nika-cell/moon-aeroponics/Расчеты/Расчет гидравлической нагрузки.docx

Расчёт гидравлической нагрузки

Методика расчёта на Земле:

*Основной закон: P=ρgh

(м.вд.ст.) – не табличная единица измерения, обозначающая давление одного метра столба воды.

1) Первостепенно определимся с давлением насоса.

Используя закон гидростатики* определим давление столба жидкости в граничном случае, когда при вертикальном положении трубки вода ещё не выходит за её границы. Таким образом предельная высота столба жидкости составила 2.9 метра, следовательно, P = 2.9 м.вд.ст.

2) Рассчитаем давление столба жидкости* в условиях строения лунной базы. Предполагаем высоту установки 1.5 метра. Тогда Pст = 1.5 м.вд.ст.

3) Оценим давление на одной форсунке. Для этого установим одну форсунку на конце трубки и замерим предельную высоту, при которой на форсунку всё ещё подаётся вода. Таким образом высота столба жидкости составила 2.7 метра, следовательно, одна форсунка принимает на себя Pфорс = 0.2 м.вд.ст.

4) Из аддитивности давления составим равенство: P_(нас) =P_(ст) +n×P_(форс) , из которого рассчитаем количество форсунок, где Pнас – давление насоса; Pст – давление нового столба жидкости; Pфорс – давление на одной форсунке; n – число форсунок.

2.9 = 1.5 + n*0.2 n = 7

Расчёт угла раствора форсунки:

Методика расчёта: эксперимент.

1) Расположим включённую форсунку на расстоянии 10 см от листа бумаги А4 и замерим диаметр получившегося пятна. Диаметр равен также 10 см.

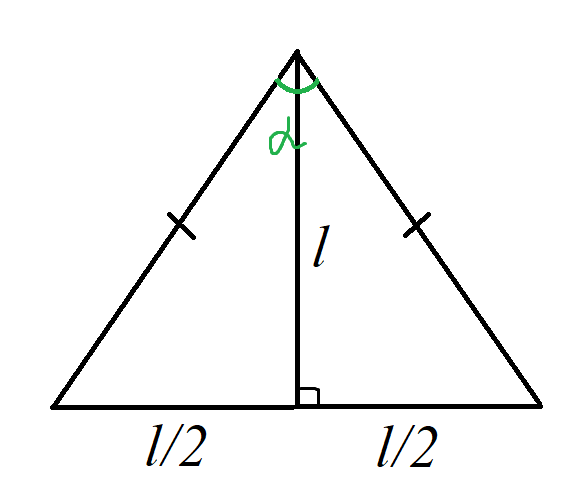
[picture p1: figure]

2) Проиллюстрируем геометрическую интерпретацию результатов эксперимента:

Здесь основание треугольника – лист бумаги. Из геометрических соображений находим, что α≈53.14
