nika-cell/moon-aeroponics/Расчеты/Расчет положения отражателей.docx

Расчёт расстояния от стенок установки до отражателей

Определим расстояние l от стенки до отражателя.

Учитывая, что α = 67.5°, R = 7.75. Из геометрических соображений находим, что l = 10.36

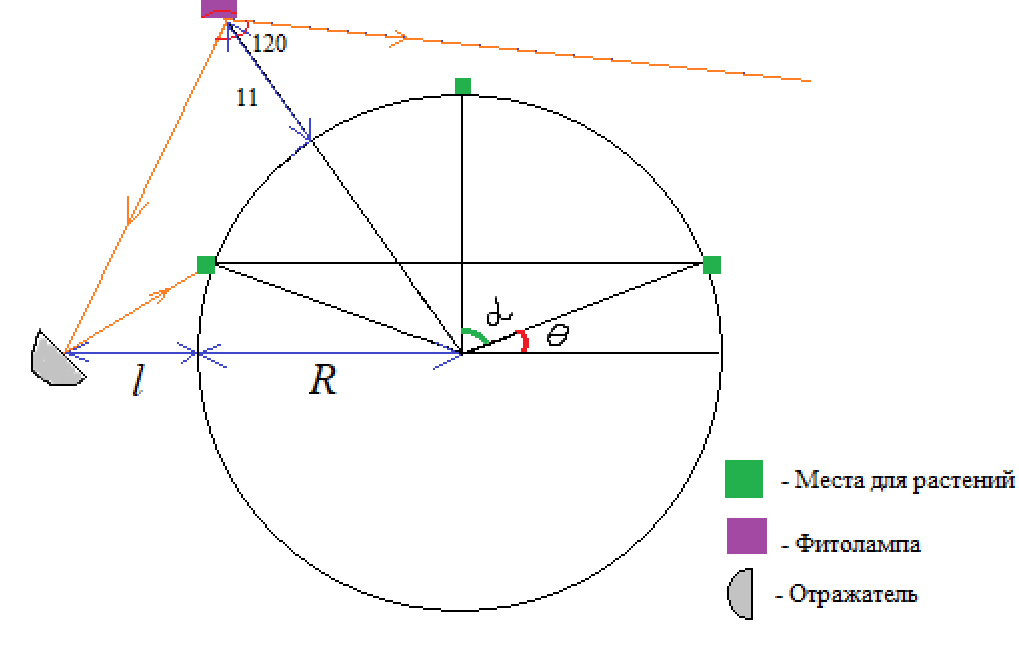
[picture p2: figure]
