nika-cell/moon-aeroponics/Расчеты/Тесты для установки.docx

Программа и методика предварительных испытаний.

Объект испытаний
Объектом испытаний является экспериментальный образец аэропонной установки в полной комплектации, включающий в себя:

- герметичный цилиндрический корпус высотой 1,5 м с ячейками, расположенными в секторе 135 градусов (10 рядов по 3 решётчатые колбы, ориентированные под углом 45 градусов внутрь объёма);
- систему орошения низкого давления на основе форсунок (расход 0,285 мл/с) и насоса;
- систему принудительной сепарации аэрозоля на основе верхнего вентилятора с выходным отверстием площадью 0,006 м²;
- приёмное ведро для сбора воды, герметично закреплённое в нижней части корпуса;
- систему освещения в составе шести фитоламп (фотопериод 16 часов) и УФ-лампы (непрерывный режим);
- систему управления на базе микроконтроллера Raspberry Pi Pico с периферийными модулями: датчик температуры и влажности DHT11, фоторезисторный модуль LM393, датчик погружения Funduino, дисплей LCD 2004 с интерфейсом I2C, энкодер KY-040, четырехканальный релейный модуль.

Цель испытаний.
Целью проведения предварительных испытаний является подтверждение работоспособности и функциональной пригодности установки к эксплуатации, а именно:

- проверка корректности и помехоустойчивости работы электронных компонентов системы управления;
- верификация заданных временных циклов орошения, вентиляции и освещения;
- подтверждение эффективности гидродинамической схемы: доставка аэрозоля в корневую зону, удержание влаги на корнях, отсутствие нештатных утечек влаги через вентиляционное отверстие;
- выявление конструктивных и программных дефектов, препятствующих стабильной работе установки в непрерывном режиме.

1. Электроника.

1.1 Проверка релейного модуля управления нагрузкой

Применяемое оборудование: стендовый источник питания, фитолампы и насос в сборе, модуль реле Songle SRD-05VDC-SL-C, Raspberry Pi Pico с тестовой прошивкой.

Методика проведения: Релейный модуль подключается к нагрузке согласно электрической схеме. На микроконтроллер загружается скетч, выполняющий следующий цикл: реле №1 замкнуто 3 секунды, пауза 2 секунды, реле №2 замкнуто 3 секунды, пауза 2 секунды. Цикл повторяется 10 раз. В ходе выполнения цикла производится визуальный контроль включения фитоламп и насоса, а также аудиальный контроль щелчков реле.

Критерии положительного результата:

- Каждое реле издаёт однократный чёткий щелчок при замыкании и размыкании. Дребезг или многократное срабатывание не допускаются.
- Микроконтроллер не уходит в перезагрузку при коммутации насосной нагрузки.
- Лампы и насос включаются и выключаются синхронно с управляющим сигналом.

1.2 Проверка датчика температуры и влажности DHT11.

Применяемое оборудование: датчик DHT11, микроконтроллер Raspberry Pi Pico, дисплей LCD 2004 или монитор последовательного порта, гидрофобный защитный колпачок из мелкопористого поролона (опционально).

Методика проведения: Датчик подключается к микроконтроллеру. Загружается скетч циклического опроса датчика с периодом 2 с и выводом измеренных значений температуры и влажности на дисплей или в монитор порта. На первом этапе датчик работает в сухом состоянии при нормальных комнатных условиях в течение 5 мин; показания должны оставаться стабильными, без скачков. На втором этапе датчик помещается в корпус установки на штатное место и запускается рабочий цикл орошения. Наблюдение за показаниями ведётся непрерывно в течение не менее 30 мин. Особое внимание уделяется моментам возрастания влажности выше 90% и последующему поведению датчика после рассеивания тумана.

Критерии положительного результата:

- В сухом состоянии показания температуры и влажности соответствуют комнатным, разовые отклонения не превышают 5% относительной влажности и 2 °C.
- При работе в аэрозольной среде показания изменяются монотонно, без мгновенных провалов до 0% и без неограниченно долгого удержания максимального значения 99% после прекращения подачи тумана.
- При обнаружении склонности датчика к конденсационному запиранию на плате должно быть предусмотрено размещение датчика в зоне вне прямого потока капель и установка защитного гидрофобного колпачка.

1.3 Калибровка и проверка датчика освещённости на модуле LM393

Применяемое оборудование: модуль датчика освещённости на LM393, микроконтроллер Raspberry Pi Pico, фитолампы и УФ-лампа в сборе, отвёртка для регулировки резистора.

Методика проведения: датчик освещённости устанавливается в корпус установки в зоне действия фитоламп и УФ-лампы. Микроконтроллер программируется на непрерывное считывание цифрового выхода компаратора. Дожидаются момента выключения фитоламп по программе при продолжающейся работе УФ-лампы. Медленно вращая резистор, добиваются переключения выходного сигнала компаратора из состояния логической единицы в состояние логического нуля. Затем принудительно включают фитолампы и убеждаются, что сигнал возвращается в состояние логической единицы. Для обеспечения запаса помехоустойчивости резистор доворачивают немного дальше найденной границы в сторону тёмного порога.

Критерии положительного результата:

- При выключенных фитолампах и включённой УФ-лампе выход компаратора стабильно удерживает логический ноль.
- При включении фитоламп выход компаратора без задержек переключается в логическую единицу.
- Ложные срабатывания, вызванные отражённым светом или флуктуациями яркости УФ-лампы, не регистрируются.

1.4 Проверка датчика погружения Funduino

Применяемое оборудование: датчик погружения Funduino, микроконтроллер Raspberry Pi Pico, шприц или пипетка с водой.

Методика проведения: датчик закрепляется вертикально в положении, соответствующем его будущей установке в корпусе. Выходной сигнал датчика выводится на монитор порта или дисплей. С помощью шприца вода медленно подаётся на верхнюю часть чувствительного элемента, имитируя стекание плёнки по стенке. Контролируется момент изменения выходного сигнала. Тест повторяется несколько раз для оценки воспроизводимости порога срабатывания.

Критерии положительного результата:

- Датчик фиксирует наличие влаги при появлении тонкой водяной плёнки на поверхности чувствительного элемента, до момента формирования сплошного потока или полного погружения.
- После прекращения подачи воды и высыхания контактов выходной сигнал возвращается в исходное состояние.

1.5 Энкодер KY-040 и дисплей LCD 2004.

Применяемое оборудование: энкодер KY-040, дисплей LCD 2004 с модулем I2C, микроконтроллер Raspberry Pi Pico, полностью собранная установка с релейным модулем, насосом и лампами.

Методика проведения: на дисплей выводится интерфейс с изменяемой переменной (значение от 0 до 100). Энкодер программируется на изменение этой переменной с шагом 1 на один щелчок. В фоновом режиме запускается полный рабочий цикл орошения и вентиляции, чтобы реле периодически коммутировали нагрузку насоса и фитоламп. В течение 5 мин оператор активно вращает энкодер, изменяя значение переменной, и одновременно наблюдает за дисплеем.

Критерии положительного результата:

- Значение переменной изменяется строго на 1 единицу за один механический щелчок энкодера. Пропуски шагов или скачки на 2 и более единиц не допускаются.
- В моменты коммутации реле дисплей не моргает, не гаснет и не отображает нечитаемые символы.
- При обнаружении сбоев, вызванных просадками напряжения, в схему должны быть добавлены сглаживающие конденсаторы по питанию микроконтроллера и дисплея, а также проверена целостность цепей заземления.

1.6 Общий шестичасовой тест электроники в полном рабочем цикле

Применяемое оборудование: установка в полной комплектации, микроконтроллер Raspberry Pi Pico с итоговой рабочей прошивкой.

Методика проведения: на микроконтроллер загружается скрипт, реализующий непрерывный рабочий цикл: форсунки включены 10 с, пауза, вентилятор включён 15 с, пауза до истечения трёхминутного интервала. Параллельно ведётся отсчёт времени для 16-часового фотопериода фитоламп. УФ-лампа и электроника запитаны непрерывно. Раз в минуту в монитор порта или в лог-файл выводятся значения всех датчиков и текущие состояния реле. Установка функционирует без вмешательства оператора в течение 6 ч.

Критерии положительного результата:

- За весь период испытаний не зафиксировано ни одной перезагрузки или зависания микроконтроллера.
- Таймер фотопериода не сбивается, фактическое время включения и выключения фитоламп соответствует заданному.
- Связь со всеми датчиками сохраняется, в логах отсутствуют периоды с нулевыми или заведомо некорректными показаниями.

2. Гидродинамика.

2.1. Проверка отсутствия выноса влаги через вентилятор на пустой камере

Применяемое оборудование: установка без растений, плёнка для герметизации посадочных отверстий, вода, салфетка из гигроскопичного материала, мерная ёмкость.

Методика проведения: все отверстия для колб герметично заклеиваются плёнкой, формируя замкнутый внутренний объём. В резервуар форсунок заливается отмеренное количество воды. Запускается рабочий цикл: раз в 3 мин форсунки распыляют туман (10 с), затем включается вентилятор (15 с). Установка выдерживается в таком режиме 1 ч. В течение этого часа к выходному отверстию вентилятора периодически прикладывается сухая салфетка на время одного полного цикла вентиляции. По истечении часа из приёмного ведра извлекается и измеряется объём собранной воды.

Критерии положительного результата:

- Салфетка за 15 с работы вентилятора не становится заметно влажной; допустимо ощущение лёгкого холодка без видимого увлажнения.
- В приёмном ведре регистрируется наличие воды, что подтверждает работоспособность системы сбора жидкости.
- Зафиксированный объём воды документируется в качестве базового значения для последующего сравнения.

2.2. Проверка удержания аэрозоля корневой системой на камере с растениями

Применяемое оборудование: установка с растениями, высаженными в колбы согласно штатной схеме, вода, мерная ёмкость.

Методика проведения: в резервуар заливается такое же количество воды, что и в тесте по п. 2.2.1. Запускается идентичный рабочий цикл орошения и вентиляции, продолжительность теста также составляет 1 ч. По окончании измеряется объём воды в приёмном ведре. Полученное значение сравнивается с базовым объёмом, зафиксированным при испытании пустой камеры.

Критерии положительного результата:

- Объём воды, собранной при работающей установке с растениями, существенно (не менее чем на 30 %) меньше базового объёма, полученного на пустой камере. Это свидетельствует об эффективном осаждении и удержании тумана корневой системой.
- Если разница объёмов составляет менее 30 %, требуются дополнительные работы по регулировке направления форсунок или изменению длительности и мощности вентилятора.

2.3. Осмотр камеры на предмет застоя воды и корректности воды

Применяемое оборудование: установка после проведения тестов по пп. 2.1. и 2.2., шприц с водой.

Методика проведения: камера вскрывается, производится визуальный осмотр внутренних стенок, дна и посадочных колб. Проверяется отсутствие луж вне приёмного ведра и скоплений воды в локальных углублениях. В каждую колбу шприцем подаётся небольшое количество воды, отслеживается направление стекания: жидкость должна возвращаться внутрь камеры, а не вытекать наружу к листьям.

Критерии положительного результата:

- Лужи и застой воды на горизонтальных поверхностях и в углублениях дна отсутствуют.
- Угол наклона колб (45°) обеспечивает стекание конденсата внутрь камеры; вытекание воды наружу к листовой части растений не зафиксировано.

2.4. Проверка влияния вентилятора на температурный режим корневой зоны

Применяемое оборудование: датчик DHT11 (или автономный датчик температуры), размещённый непосредственно в корневой зоне одного из средних ярусов.

Методика проведения: в процессе общего длительного теста или отдельного часового прогона непрерывно регистрируется температура в корневой зоне. Сравниваются показания в моменты работы вентилятора и в паузах. Важно убедиться, что вентилятор, сдувая капли, не перегревает и не переохлаждает корневую зону за счёт интенсивного движения воздуха.

Критерии положительного результата:

- Колебания температуры в корневой зоне в течение полного цикла (3 минуты) не превышают 3 °C.
- Температура не выходит за пределы оптимального для тестовой культуры диапазона (обычно 18-26 °C).
- Если перепады значительны, рассматривается снижение оборотов вентилятора или увеличение паузы между орошением и вентиляцией.
