nika-cell/moon-aeroponics/Расчеты/Отчёт влияния установки (тепловыделение и влаговыделение) на лунную базу.docx

Отчет влияния аэропонной установки (тепловыделение и влаговыделение) на лунную базу.

Интеграция аэропонной установки в замкнутый контур лунной базы требует точной оценки её влияния на общую экосистему модуля. Имея энергопотребление в 238,18 Вт, комплекс выступает не только потребителем ресурсов, но и активным источником тепла и влаги за счет работы оборудования и испарения воды растениями. Этот отсчёт анализирует эти факторы для бортовых систем терморегулирования и кондиционирования. Главной целью отсчёта является обосновать соразмерность нагрузок и доказать, что выделения установки не окажут сильного влияния на инфраструктуру базы.

1) Тепловыделение

Для оценки степени воздействия ниже приведено сопоставление параметров проектируемого оборудования с номинальными эксплуатационными лимитами как всей станции, так и отдельных лабораторных модулей (например, МЛМ-У «Наука»).

Параметр СЭС | Значение для МКС / Модулей | Параметр нашей нагрузки | Доля от лимита станции / модуля
Допустимое постоянное потребление МКС | 75 000 – 90 000 Вт (75–90 кВт) | 238,18 Вт (Общее) | ~0,29% от базового потребления станции
Пиковая мощность СЭС МКС (iROSA) | 215 000 Вт (215 кВт) | 238,18 Вт (Общее) | ~0,11% от пиковой мощности МКС
Лимит СЭС модуля «Наука» | 2 500 Вт (2,5 кВт) | 238,18 Вт (Общее) | ~9,5% от номинала одного модуля
Ограничение на полезную нагрузку РС | 1 500 Вт (1,5 кВт на модуль) | 238,18 Вт (Общее) | ~15,8% от лимита научных систем модуля

Проектируемый комплекс оборудования имеет совокупное энергопотребление 238,18 Вт, что составляет менее одной трети процента от постоянной располагаемой мощности МКС и полностью удовлетворяет ограничениям по полезной нагрузке для Российского сегмента (1,5 кВт).

Итоговый вывод: Эксплуатация данной аппаратуры абсолютно безопасна, полностью исключает риски перегрузки бортовой сети и не нанесет ущерба энергоснабжению других систем станций.

2) Влаговыделение

Проектируемая аэропонная установка представляет собой закрытый вертикальный цилиндр, который практически изолирован от внешней среды. Единственными каналами связи с атмосферой лунной базы являются листья растений, выведенные наружу, и небольшое отверстие сверху площадью 0,006 м², где установлен вентилятор. Проведенные расчеты показывают, что благодаря такой конструкции и прерывистому режиму полива установка выделяет минимальное количество влаги и оказывает минимальное влияние на станцию.

1) Форсунки работают 10с раз в 3 минуты. Это 480 циклов в сутки. Проведя расчеты, мы определили, что производительность форсунок равна 0.285 мл/с. Тогда за один впрыск длительностью 10 секунд форсунки расходуют 0.285*10 = 2.85мл. Общая масса воды, участвующей в одном цикле (за все 480 циклов) = 2.85*480 = 1368мл = 1,37л.

Вентилятор дует 15 секунд после выключения форсунок. Этот направленный поток воздуха действует в одном направлении с силой тяжести и прижимает туман к стенкам цилиндра, что также уменьшает испарение влаги наружу.

2) Около 55% всей воды, выдуваемой форсунками корни впитают в себя. Это влага испариться листьями наружу: 1.37л * 0.55 = 0.75 л/сут.

3) Также стоит учесть, что пока вентилятор отключен (165 секунд из 180 в каждом цикле), влажный воздух из бочки медленно уходит наружу через верхнее отверстие S=0,006м² за счет разности давлений и диффузии молекул пара. Возьмем усредненное значение, около 15%: 1.37л * 0.15 = 0.21 л/сут.

ИТОГО: 0.75 + 0.21 = 0.96 л/сут.

4) Чтобы оценить критичность получившихся 0.96 л/сут., сопоставим их со стандартными космическими показателями СЖО:

- Один космонавт только при дыхании и потоотделении выделяет в среднем 2 л/сут влаги. Наша установка выделяет около 0.96 л/сут.
- Бортовые системы кондиционирования воздуха (как на МКС) штатно рассчитаны на сбор до 30 литров (ИМБП РАН “СИСТЕМЫ ЖИЗНЕОБЕСПЕЧЕНИЯ ОБИТАЕМЫХ КОСМИЧЕСКИХ ОБЪЕКТОВ”) конденсата в сутки. Наша установка займет от этой мощности всего: 0.96л/30л * 100 = 3.2% - что является минимальным влиянием на общую систему СЖО.

Из всего вышесказанного следует, что нагрузка на систему осушения воздуха лунной базы составляет всего около 3%. Это уменьшает риск появления избыточной сырости, плесени или короткого замыкания приборов.
