nika-cell/moon-aeroponics/Расчеты/Расчёт ламп.docx

Расчёт расстояния h от ламп до растений.

Метод расчёта: теоретический

Основные формулы:

* PPFD=Φ/S ; где Φ – фотонный поток одной лампы = 36 мкмоль/с, S – эффективная площадь засветки.

**S = W×L; где W – ширина засветки, L – длина лампы.

*** W=2×h×tan(α/2) , где α – угол раствора одной лампы, экспериментально определённый как 120°

Кейл, мангольд и базилик – светолюбивые культуры. Для активного набора биомассы им требуется PPFD в диапазоне 200-300 мкмоль/м²*с при периоде освещения 16 часов.

Из формул, приведённых выше с учётом количества ламп, равного 6 определим расстояние от ламп до растений в разные стадии роста, объединив примерные диапазоны показаний PPFD.

Растения | Диапазон PPFD (мкмоль/м²*с)
| Проращивание семян | Нарост зелёной массы
Кейл | 200-400 | 400-700
Мангольд | 100-200 | 250-400
Базилик | 100-300 | 250-400

Итого:

PPFDпроращ = 200 мкмоль/м²*с => h1 = 0.21 м

PPFDнар = 400 мкмоль/м²*с => h2 = 0.1 м
