nika-cell/moon-aeroponics/Расчеты/Концепция лунных баз, системы жизнеобеспечения и космические оранжереи.docx

### Отчет: Концепция лунных баз, системы жизнеобеспечения и космические оранжереи

#### 1. Зачем человечеству лунные базы?

Создание постоянно действующих баз на Луне является ключевым этапом в трансформации подходов к освоению космоса, обусловленным несколькими стратегическими и практическими причинами:

- Использование местных ресурсов (ISRU): Луна рассматривается как источник важнейших ресурсов, в первую очередь — водяного льда, обнаруженного в постоянно затененных полярных кратерах. Лед можно перерабатывать в питьевую воду, кислород для дыхания экипажа и водородно-кислородное ракетное топливо. Местный грунт (реголит) планируется плавить и использовать для 3D-печати строительных конструкций. В долгосрочной перспективе Луна интересна добычей изотопа гелия-3 для чистой термоядерной энергетики и редкоземельных металлов.
- Подготовка к полетам на Марс: Луна является идеальным испытательным полигоном. В условиях вакуума, космической радиации, абразивной лунной пыли и пониженной гравитации (1/6 от земной) человечество сможет отработать замкнутые системы жизнеобеспечения, ядерные генераторы, скафандры и робототехнику перед отправкой людей на Марс.
- Наука и геополитика: Освоение Луны связано с геополитическим соперничеством космических держав за стратегически важные территории, особенно на Южном полюсе. Кроме того, база на обратной стороне Луны позволит разместить астрономические обсерватории, свободные от радиопомех Земли.

#### 2. Архитектурный облик лунной базы

Сегодня формируются две основные концепции лунных баз — американская (программа Artemis) и российско-китайская (Международная научная лунная станция, МНЛС). Обе станции планируется разместить в районе Южного полюса Луны, так как там есть пики вечного света для солнечных батарей и лед в темных кратерах.

- Облик базы Artemis (Artemis Base Camp): Центральным элементом станет Базовый обитаемый модуль (FSH). Он представляет собой трехэтажную гибридную конструкцию высотой около 7,8 метра. Нижний ярус — это жесткий металлический цилиндр (диаметром 4,4 м), где разместятся шлюз, зона очистки скафандров от пыли и мастерская. Два верхних этажа заключены в надувную оболочку (в развернутом виде диаметром 6,5 м), где будут находиться спальные каюты, медицинский отсек, биологическая лаборатория и тренажеры для поддержания мышечной массы. По поверхности космонавты будут перемещаться на открытых луноходах и внутри Герметичного ровера.
- Облик МНЛС (Россия/Китай): Эта база будет иметь высокоавтоматизированную распределенную структуру, в том числе с возможностью подземного базирования. Китайские инженеры рассматривают развертывание надувных жилых модулей внутри естественных лунных пещер — лавовых трубок, что обеспечит идеальную защиту от радиации, метеоритов и резких перепадов температур. Над входами в пещеры мобильные роботы-3D-принтеры напечатают защитные купола из реголита, а сообщение с поверхностью обеспечит лифт. Энергию базе должна давать компактная автоматическая ядерная электростанция (например, российская установка на базе реактора «Елена-АМ»).

#### 3. Экипаж: численность и сроки пребывания

Продолжительность нахождения людей на Луне ограничивается запасами ресурсов и предельными дозами радиации, поэтому длительность миссий будет увеличиваться постепенно.

- Программа Artemis: На первом этапе высадки (миссия Artemis III) на поверхность отправятся 2 астронавта на 7 суток. В дальнейшем (после 2028-2030 гг.), когда будет построен модуль FSH, экипаж расширится до 4 человек, а срок пребывания составит от 30 до 45 суток (в перспективе — до 60 дней или 2 месяцев).
- Программа МНЛС: На первых этапах база будет строиться роботами в полностью беспилотном режиме. С 2036 года начнутся высадки пилотируемых экипажей в составе 3–4 человек. Первые вахты составят около 14 суток (один лунный день), а после введения в строй надежных укрытий и оранжерей их длительность возрастет до 60–90 суток.
- В инженерных расчетах лунных теплиц (например, европейский проект GHM) урожай и системы жизнеобеспечения оптимизируются на длительное поддержание экипажа из 6 человек.

#### 4. Космические фермы и теплицы (Оранжереи)

##### Зачем они нужны?

По мере удлинения миссий доставка всех припасов с Земли становится нерентабельной, поэтому базы должны переходить на биорегенеративные системы жизнеобеспечения (BLSS).

1. Питание: Фермы должны обеспечивать от 50% до 100% суточных калорий. Более того, длительная космическая радиация разрушает витамины в консервах, поэтому для защиты здоровья космонавтам жизненно необходима свежая пища, богатая антиоксидантами и витаминами.
2. Регенерация атмосферы и воды: Растения перерабатывают выдыхаемый углекислый газ в кислород для дыхания (фотосинтез), а также работают как биофильтры, испаряя через листья влагу (транспирация), которая затем конденсируется в чистую воду.
3. Психологическая поддержка: Уход за растениями и наличие зеленого, яркого окружения серьезно снижают психологический стресс экипажа в условиях экстремальной изоляции.

##### Конструкция лунных ферм

Космические фермы проектируются с учетом лунной гравитации и дефицита ресурсов:

- Greenhouse Module (GHM, проект ESA): Это крупная гибридная теплица, состоящая из центрального жесткого ядра (с насосами и климат-контролем) и четырех гигантских надувных лепестков. Полезная площадь выращивания составит 658 м² (в 5 ярусов), что позволит произвести 4100 кг пшеницы, сои, картофеля и салатов за 655 суток.
- Mars-Lunar Greenhouse (Университет Аризоны): Надувные цилиндрические теплицы длиной 5,5 метра, где разные растения (помидоры, клубника, салат) растут вместе по технологии "кабельной культуры" с использованием светодиодов, охлаждаемых водой.
- «Витацикл-Т» (Россия): Инновационная малогабаритная оранжерея для выращивания салатов, редиса и зелени. Она представляет собой вращающийся цилиндрический барабан, где растения растут корнями наружу, а листьями внутрь, к источнику света. Для освещения применяются монохроматические и импульсные светодиоды (красный, синий, зеленый, УФ), работающие в режиме стробоскопа (например, 1 секунда света, 3 секунды темноты), что позволяет растениям усваивать кванты света при радикальном снижении затрат электроэнергии.
- В качестве субстрата обычную землю использовать нельзя из-за гниения и непредсказуемости бактерий; вместо нее используются искусственные минераловатные коврики, гидропоника, а также войлочные ткани с ионообменными смолами.

##### Упоминаются ли методы аэропоники?

Да, методы аэропоники упоминаются напрямую. В европейском проекте оранжереи Greenhouse Module (GHM) система подачи питательных веществ (NDS) спроектирована по гибридному принципу: она сочетает аэропонные форсунки-распылители (с шагом в 20 см) и метод питательного слоя (NFT). Кроме того, при исследованиях поведения жидкостей в космосе подчеркивается, что пониженная гравитация принципиально меняет динамику движения воды. Земная гравитация естественным образом направляет потоки воды и формирует зону корней, тогда как на Луне (1/6 G) эти изменения критически влияют на смачивание почвы, а также на эффективность работы аэропоники и гидропоники, что требует адаптации распылительных насосов и систем циркуляции растворов.
