nika-cell/moon-aeroponics/Электроника/Калибровка датчиков.docx

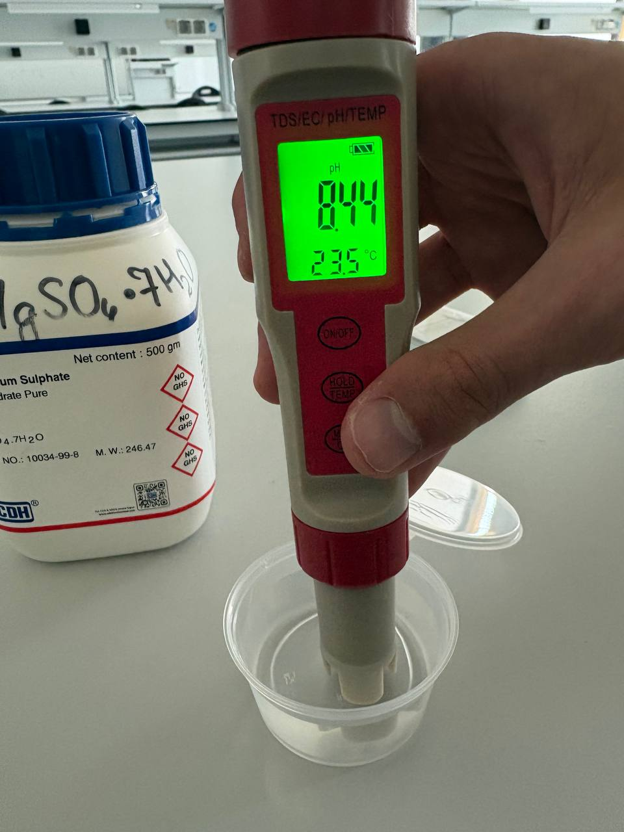
[picture p3: figure]
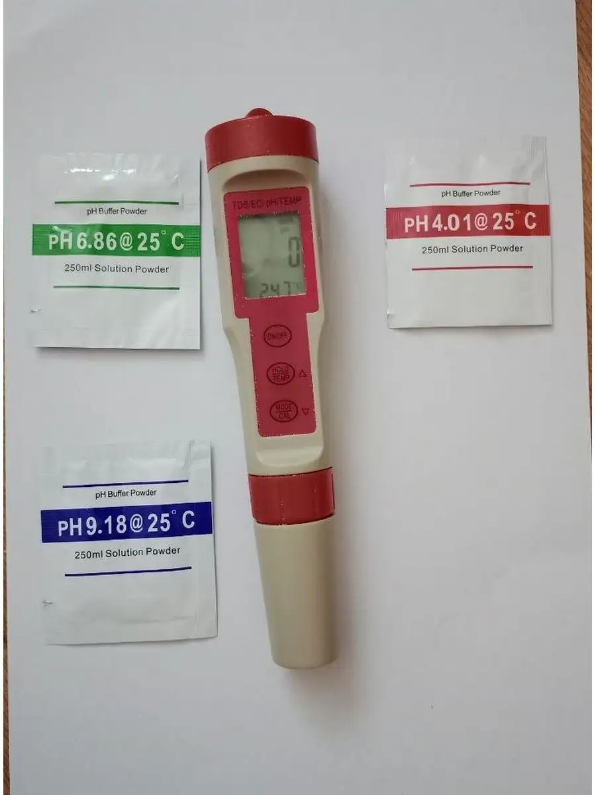
[picture p4: figure]

Калибровка датчиков

Был откалиброван датчик Water quality tester EZ-9908/686. Для этого мы использовали дистиллированную воду и набор из трёх различных pH Buffer Powder. Мы растворили каждый концентрат в отдельных емкостях с дистиллированной водой (250мл). Для начала мы измерили показатели датчика в дистиллированной воде, а затем опустили в раствор pH 9.18.

Видно, что значение неверно. Мы откалибровали датчик, опираясь на номинальные значения, указанные на упаковках. Когда значения для 3-х растворов совпали с заявленными, мы определили, что датчик откалиброван и готов к работе.

Калибровка датчика Funduino - Water Level Sensor. Для этого мы воспользовались линейной интерполяцией. Для начала мы измерили показатели датчика в полностью сухом состоянии RAW_DRY = 512. Затем датчик был полностью погружен в воду, где АЦП получил значение RAW_WET = 17100. Рабочий диапазон датчика имеет 4 см. Из разницы этих показателей был вычислен чистый рабочий диапазон устройства RANGE_VAL = 16588 единиц.

Значение в см=(Значение АЦП)/16588×4 см
