nika-cell/moon-aeroponics/Биология/Выбор культур для выращивания.docx

### Отчет о выборе культуры для выращивания

### 1. Целесообразности перехода к биорегенеративным системам жизнеобеспечения на лунной базе

Создание лунных баз требует перехода от модели снабжения с Земли к модели замкнутого цикла. При текущей стоимости лунной логистики (~$1.2 млн за 1 кг), обеспечение одного космонавта физиологической нормой свежей зелени (150 г/сутки) путем прямых поставок обойдется бюджету миссии в $16.2 млн ежемесячно. Локальное выращивание биомассы на базе аэропонной ЗСЖО полностью окупает стартовую массу оборудования всего за 4 месяца, сокращая эксплуатационные издержки почти в два раза.

Помимо математически доказанной экономической эффективности и гарантии выживания при задержках грузовых кораблей , выращивание растений в космосе решает три критические задачи:

- Регенерация среды: Растения поглощают углекислый газ и вырабатывают кислород, а также участвуют в транспирации, очищая воду внутри жилого модуля.
- Биологическая безопасность и нутритивная поддержка: Свежая продукция является источником фитонцидов и живых микроорганизмов, поддерживающих микробиом кишечника космонавтов. Кроме того, она компенсирует дефицит лабильных нутриентов, которые не могут полностью заменить синтетические добавки.
- Психологический комфорт: «Эффект оранжереи» снижает уровень стресса у экипажа, находящегося в условиях сенсорной депривации.

### 2. Ограничения сублимированных рационов и синтетических БАДов

На сегодняшний день энергетическая потребность космонавтов на МКС (2500–3000 ккал в сутки) покрывается за счет запасов сублимированных, облученных и термостабилизированных блюд. Однако для длительных лунных и марсианских миссий такая модель питания имеет два ограничения, требующих обязательной компенсации свежей фитомассой.

#### 2.1. Деградация витаминов и разрушение костной ткани

Хотя общая калорийность космических консервов сохраняется длительное время, их микронутриентный профиль стремительно разрушается. Согласно анализу Космического центра имени Линдона Джонсона (NASA), оценивающему космическую еду после 1–3 лет хранения, концентрация лабильных витаминов падает до критических значений:

- Витамин С: В фруктовых и овощных пайках деградирует на 32–83% к третьему году хранения.
- Витамин B1 и фолиевая кислота: В некоторых позициях меню (например, лепешках тортилья и овощных гарнирах) концентрация падает на 50% уже в первый год. (Источник данных: Национальная медицинская библиотека США (NCBI), "Initial assessment of the nutritional quality of the space food system over three years of ambient storage" — (https://pmc.ncbi.nlm.nih.gov/articles/PMC5466603/)https://pmc.ncbi.nlm.nih.gov/articles/PMC5466603/)

Более того, изначальная агрессивная термическая обработка (стерилизация) приводит к тому, что концентрации витамина К, калия и кальция в космических пайках стабильно оказываются на 13–20% ниже физиологической нормы космонавта.

Этот дефицит (в первую очередь витамина К и кальция) опасен для опорно-двигательного аппарата. Медицинские данные NASA подтверждают, что в условиях сниженной гравитации космонавты теряют от 1% до 1.5% минеральной плотности костной ткани ежемесячно. (Источник данных: Официальный портал NASA, "Risk of Spaceflight-Induced Bone Changes" — (https://www.nasa.gov/reference/risk-of-spaceflight-induced-bone-changes/)https://www.nasa.gov/reference/risk-of-spaceflight-induced-bone-changes/)

Синтетические витаминно-минеральные комплексы (БАДы) не могут решить эту проблему. Изолированные витамины обладают сниженной биодоступностью, так как усваиваются значительно хуже природных аналогов, работающих в растительной матрице совместно с клетчаткой и энзимами.

#### 2.2. Синдром «пищевой усталости»

Вторая фундаментальная угроза длительных миссий — нейропсихологическая. В условиях микрогравитации жидкости в теле перераспределяются, что вызывает отек слизистых и меняет чувствительность обонятельных и вкусовых рецепторов.

Длительное употребление консервированной пищи (даже при наличии 200 позиций в меню МКС) неизбежно вызывает так называемую «пищевую усталость». Сублимированные продукты теряют текстурную и вкусовую привлекательность. Как отмечают ученые Advanced Food Technology project NASA, потеря пищевого интереса приводит к тому, что экипаж систематически недополучает калории, что провоцирует опасную потерю массы тела, истощение и падение иммунитета. (Источники данных: Отчет NASA "How Does Spaceflight Change Food Appeal?" — (https://www.nasa.gov/humans-in-space/how-does-spaceflight-change-food-appeal/)https://www.nasa.gov/humans-in-space/how-does-spaceflight-change-food-appeal/ ; Исследование Мельбурнского университета — (https://pursuit.unimelb.edu.au/articles/why-do-food-and-drink-taste-different-in-space)https://pursuit.unimelb.edu.au/articles/why-do-food-and-drink-taste-different-in-space)

#### Вывод: Клиническая необходимость аэропонной биомассы

Включение в рацион свежевыращенной аэропонной фитомассы — это не просто гастрономическое удовольствие, а безальтернативный клинический инструмент жизнеобеспечения. Свежие, хрустящие листья кейла и мангольда, а также высокая концентрация эфирных масел в базилике обеспечивают мощную ольфакторную (обонятельную) и текстурную стимуляцию. Это физиологически «перезагружает» рецепторы космонавтов, преодолевает вкусовую апатию и стимулирует активную выработку пищеварительных ферментов. Одновременно с этим локальное выращивание гарантирует экипажу поставку 100% биодоступных, не деградировавших от времени витаминов C и K, останавливая разрушение костной ткани и поддерживая метаболический гомеостаз.

### 3. Сравнительный анализ сельскохозяйственных культур

Для определения оптимального состава фитомассы был проведен многофакторный анализ 15 видов листовых культур. Оценка проводилась по целевым показателям электропроводности (EC), потреблению NPK, требованиям к освещенности (PPFD) и концентрации критических микронутриентов.

Таблица 1. Матрица нутриентного и инженерного профиля культур

Культура | Целевой EC (мСм/см) | NPK профиль | PPFD (μмоль) | Вит. С (мг) | Вит. А (мкг RAE) | Вит. K (мкг) | Железо (мг) | Кальций (мг) | Магний (мг)
Кейл | 1.7 | 15-10-20 | 350 | 120 | 500 | 817 | 1.5 | 150 | 33
Базилик | 1.8 | 16-10-20 | 400 | 18 | 264 | 415 | 3.2 | 177 | 64
Мангольд | 1.7 | 15-10-20 | 300 | 30 | 306 | 830 | 1.8 | 51 | 81
Шпинат | 1.7 | 16-10-20 | 300 | 28 | 469 | 483 | 2.7 | 99 | 79
Петрушка | 1.7 | 15-10-20 | 350 | 133 | 421 | 1640 | 6.2 | 138 | 50
Мизуна | 1.5 | 15-10-20 | 250 | 40 | 150 | 300 | 1.5 | 110 | 20
Укроп | 1.7 | 15-10-20 | 350 | 85 | 380 | 390 | 6.6 | 208 | 55
Горчица | 1.5 | 15-10-20 | 250 | 70 | 200 | 250 | 1.4 | 105 | 33
Рукола | 1.4 | 14-10-18 | 250 | 15 | 119 | 109 | 1.4 | 160 | 47
Ромэн | 1.2 | 12-8-15 | 250 | 24 | 436 | 102 | 0.9 | 33 | 14
Лолло Росса | 1.2 | 12-8-15 | 250 | 10 | 150 | 140 | 1.0 | 30 | 15
Цикорные | 1.2 | 12-8-15 | 250 | 5 | 10 | 15 | 0.8 | 20 | 10
Адамант | 1.0 | 10-8-12 | 200 | 5 | 50 | 20 | 0.5 | 20 | 10
Дубачек | 1.0 | 10-8-12 | 200 | 5 | 50 | 20 | 0.5 | 20 | 10
Анапчанин | 1.0 | 10-8-12 | 200 | 5 | 50 | 20 | 0.5 | 20 | 10

### 4. Обоснование выбора целевой триады (Кейл, Мангольд, Базилик)

Анализ данных Таблицы 1 выявил неэффективность культивации водянистых салатов (Адамант, Дубачек, Анапчанин) из-за их низкой нутритивной плотности. Для аэропонной системы были окончательно выбраны Кейл, Мангольд и Базилик по следующим причинам:

1. Кейл: Является признанным «суперфудом» с экстремально высоким содержанием витаминов K, A, C и антиоксидантов. Культура обладает высокой устойчивостью к перепадам внешних условий.
2. Мангольд: Листовая свекла, отличающаяся высокой концентрацией железа, магния и калия. Ее ключевое преимущество — высокая скорость регенерации листьев после частичного среза.
3. Базилик: Выступает мощным источником эфирных масел, обладающих доказанными антибактериальными свойствами, что критически важно для стерильных условий станции. Помимо этого, базилик значительно улучшает вкусовые качества пресной сублимированной пищи.

Эти три культуры представляют собой оптимальный баланс между неприхотливостью в уходе, высокой питательной плотностью и способностью к многократному плодоношению.

### 5. Выбор парадигмы: полноценные культуры против микрозелени

На этапе эскизного проектирования в качестве альтернативного сценария рассматривалась культивация микрозелени (проростков на 10–14 дней вегетации). Несмотря на популярность этого метода, обусловленную высокой скоростью получения первого урожая, детальный физиолого-экономический анализ показывает, что для задач длительных космических миссий микрозелень критически проигрывает взрослым листовым культурам по трем фундаментальным параметрам.

#### 5.1. Логистическая экономика семенного фонда (Коэффициент конверсии)

Главная логистическая проблема микрозелени — метод ее сбора (растение срезается целиком на ранней стадии) и экстремально низкий коэффициент конверсии массы семян в съедобную биомассу. В среднем, для получения 1 кг микрозелени требуется от 100 до 150 граммов сухих семян (соотношение 1:8).

- Сценарий «Микрозелень»: Для обеспечения 1 космонавта физиологической нормой 150 г зелени в день (4.5 кг за цикл), с Земли необходимо ежемесячно доставлять около 450–500 граммов семян.
- Сценарий «Взрослые растения»: Культуры вроде Кейла и Мангольда обладают способностью к многократной регенерации (метод частичной срезки). Аэропонная установка на 30 посадочных мест засевается один раз на период до 60–75 дней. После этого срока производится плановая замена растений, чтобы избежать огрубения стеблей, падения урожайности и критического разрастания корневой массы внутри трубы. Стартовая масса семенного фонда, даже с учетом плотного мультипосева (по 3–4 семени в лунку), составляет не более 1.5–2.0 граммов на весь двухмесячный цикл. Вывод: Использование взрослых регенеративных растений снижает логистическую нагрузку на доставку посевного материала почти в 500 раз.

#### 2. Дифференциация нутриентного профиля: Витамины против Минералов

В популярной литературе часто упоминается сверхвысокая концентрация витаминов в микрозелени. Однако необходимо строго разделять эндогенные витамины (синтезируемые самим ростком из запасов семечка) и экзогенные минералы (накапливаемые из питательного раствора).

- Минеральный дефицит микрозелени: Жизненный цикл микрозелени составляет 10–14 дней. За это время корневая система просто не успевает абсорбировать и аккумулировать значимые объемы макро- и микроэлементов из воды. Микрозелень остается бедной на кальций, магний и железо.
- Минеральная плотность взрослых растений: Взрослый Кейл и Мангольд, находясь в аэропонном контуре более 30 дней, работают как мощные биоаккумуляторы. Обладая развитой корневой системой, они непрерывно перекачивают через себя насыщенный питательный раствор. В результате 100 г взрослого Кейла содержат до 150 мг биодоступного кальция и 33 мг магния — элементов, критически важных для торможения процессов вымывания костной ткани (остеопении) в условиях лунной гравитации. Микрозелень не способна обеспечить такой уровень минеральной поддержки.
- Синтез фитонцидов: Для формирования сложного профиля эфирных масел (эвгенол, линалоол) растению требуется время. Взрослый Базилик при регулярной прищипке (частичной срезке верхушек) генерирует высокую концентрацию этих веществ, обеспечивающих антибактериальный эффект и стерилизацию микрофлоры полости рта космонавта. В микрозелени базилика эфирные масла просто не успевают синтезироваться в терапевтически значимых объемах.

#### 3. Гастроэнтерологический фактор: Структурная клетчатка

В условиях микрогравитации и гиподинамии одной из главных проблем здоровья экипажа становится атония желудочно-кишечного тракта (замедление перистальтики).

- Микрозелень состоит преимущественно из воды и первичных эмбриональных тканей (семядолей), содержание структурной (неперевариваемой) клетчатки в ней ничтожно мало (менее 0.5%).
- Зрелые листья Кейла и Мангольда содержат развитый ксилемный каркас — от 2.5 до 4.0 граммов грубой клетчатки (целлюлозы и гемицеллюлозы) на каждые 100 граммов массы. Ежедневное потребление 150 граммов таких листьев обеспечивает экипаж 5–6 граммами пищевых волокон. Это обеспечивает необходимую механическую стимуляцию стенок кишечника, нормализует моторно-эвакуаторную функцию ЖКТ и служит питательной средой для сохранения симбиотического микробиома.
- Сформированные, плотные листья взрослого Базилика обладают интенсивным ароматом и вкусом, которые физиологически необходимы для преодоления вкусовой апатии к сублимированным рационам и стимуляции выработки пищеварительных ферментов

Резюме: Выбор взрослых листовых культур с циклом 60–75 дней (Кейл, Мангольд, Базилик) является единственным способом обеспечить экипаж комплексной поддержкой — от восполнения дефицита минералов до механической стимуляции работы пищеварительной системы, сохраняя при этом жесткую логистическую экономию семенного фонда.

### 6. Технологическое преимущество аэропоники в условиях лунной гравитации

Реализация проекта требует применения наиболее эффективного метода культивирования. В условиях лунной космической станции выбор аэропоники обусловлен не только жесткой экономией веса (отказом от субстратов, являющихся исключительно «мертвым грузом» для логистики), но и специфической физикой процессов в условиях пониженной гравитации (1/6 g на поверхности Луны). Данная технология дает возможность максимально точно дозировать питательные вещества, подаваемые непосредственно к корневой системе растения.

При переходе к лунной гравитации традиционные методы выращивания, такие как почвенное земледелие или классическая гидропоника, сталкиваются с критическими гидродинамическими ограничениями. В отличие от земных условий, где распределение влаги и газов в грунте регулируется гравитацией, при 1/6 g оно может быть нарушено и крайне неравномерно из-за отсутствия нормальной конвекции. Силы поверхностного натяжения начинают преобладать над гравитационными, что приводит к эффекту капиллярного запирания: свободная вода не дренирует вниз, а образует сплошные водяные замки. Одновременно с этим исчезает плотностная конвекция жидкостей, из-за чего вокруг корней формируются застойные слои, препятствующие диффузии кислорода и вызывающие анаэробное удушье.

Разрабатываемая аэропонная установка нивелирует указанные гравитационные аномалии за счет принудительного механического распыления питательного раствора. Мелкодисперсный туман, обладая высокой кинетической энергией, пробивает застойные пограничные слои, доставляя влагу и минеральные соли напрямую к клеточным мембранам. Это обеспечивает идеальную, постоянную аэрацию корней.

Однако специфическим гидродинамическим эффектом лунной гравитации является то, что даже после мелкодисперсного орошения капли склонны к коалесценции на корневой системе. Из-за ослабленного вектора гравитации они формируют устойчивую водяную пленку, которая не дренирует естественным путем и может спровоцировать острую корневую гипоксию, так как кислород диффундирует в воде на порядки медленнее, чем в воздухе. Для полного устранения этого риска в архитектуру установки интегрирован контур принудительного аэродинамического сброса влаги. После каждого цикла распыления активируется направленный поток воздуха сквозь корневую камеру, который механически сдувает избыточные капли, преодолевая поверхностное натяжение, и оперативно возвращает излишки воды в нижний бак для рециркуляции. Это мгновенно восстанавливает прямой контакт корневых чехликов с газовой средой, гарантируя беспрепятственное дыхание.

Комплексное применение фазового распыления раствора и последующего аэродинамического сброса влаги предотвращает развитие патогенной микрофлоры (гнили). Это важно в замкнутом пространстве базы, где любая появившаяся плесень может стать угрозой для здоровья экипажа и целостности электронного оборудования. Таким образом, модифицированная аэропоника исключает условия для образования анаэробных очагов, обеспечивая микробиологическую стерильность и абсолютную технологическую надежность системы биорегенерации лунной станции.

### Заключение

Переход к выращиванию полноценных листовых культур вместо использования только микрозелени — это необходимый шаг в развитии космического сельского хозяйства. Развитие интегрированных аэропонных систем на лунных базах позволит не только гарантированно обеспечить экипаж необходимыми витаминами и клетчаткой, но и создаст прочный фундамент для долгосрочной колонизации космоса. Эта технология является ключом к превращению исследовательских станций в полностью автономные экосистемы, способные поддерживать жизнь человека вдали от Земли.
