nika-cell/moon-aeroponics/Расчеты/Экономический расчет целесообразности перехода к биорегенеративным системам жизнеобеспечения на лунной базе.docx

### Экономический расчет целесообразности перехода к биорегенеративным системам жизнеобеспечения на лунной базе

Обеспечение жизнедеятельности экипажа в условиях лунной гравитации и повышенного радиационного фона требует строгого соблюдения метаболического баланса. Базовые энерготраты космонавта при выполнении работ на лунной поверхности составляют 2500–3000 ккал в сутки. Энергетическая (калорийная) и макронутриентная (белки, жиры, углеводы) потребность успешно и экономически эффективно закрывается сублимированными и термостабилизированными рационами глубокой переработки.

Однако ключевой проблемой долгосрочных космических миссий является деградация лабильных микронутриентов. В условиях длительного хранения (более 6–8 месяцев), особенно при воздействии космической радиации на складские модули, в сублимированных пайках происходит распад критически важных витаминов и антиоксидантов:

1. Витамин C (Аскорбиновая кислота): Суточная потребность составляет 90–100 мг. Является главным антиоксидантом, защищающим клетки от радиационного окислительного стресса. В сублиматах его биодоступность падает на 40–60% в течение первого года хранения.
2. Витамин K (Филлохинон): Суточная потребность 120 мкг. Критически важен для синтеза остеокальцина — белка, удерживающего кальций в костях. В условиях лунной гравитации 1/6g дефицит витамина К приводит к стремительной остеопении, даже при избытке кальция в БАДах.
3. Витамин А и каротиноиды: Суточная норма 900 мкг RAE. Необходимы для регенерации слизистых оболочек и поддержания зрительной функции.

Синтетические витаминно-минеральные комплексы (БАДы) обладают сниженной биодоступностью из-за отсутствия растительных кофакторов (флавоноидов, энзимов и пищевых волокон). Для поддержания гомеостаза экипажу физиологически необходимо потребление свежей растительной биомассы, выступающей не источником калорий, а высокоэффективным биореактором микронутриентов.

Медицинские нормы космического питания устанавливают минимальную физиологическую потребность в свежей растительной массе на уровне 150 грамм в сутки на одного члена экипажа для перекрытия дефицита лабильных витаминов.

#### 1.1. Базовые параметры логистики и физиологические нормы

Расчеты производятся для миссии с участием 1 члена экипажа (космонавта) на протяжении одного вегетационного цикла установки (30 суток), исходя из следующих констант космической логистики и медицины:

- Стоимость доставки груза на поверхность Луны (Clog): $1 200 000 / кг.
- Суточная физиологическая норма свежей витаминной зелени (Mday): 0.15 кг/сутки (150 грамм).
- Потребность за один вегетационный цикл (30 суток): 30×0.15=4.5 кг биомассы.

#### 2. Вариант А: Традиционная логистическая модель (Прямое снабжение с Земли)

Поскольку свежие растительные продукты (салаты) состоят из воды более чем на 90% и имеют ограниченный срок хранения, их доставка в свежем виде требует специализированных контейнеров с системой поддержания микроклимата(РГС -регулируемая газовая среда и холодильной установки). Масса тары и систем охлаждения составляет в среднем 2 раза привышает от массы полезного груза (коэффициент тары kt=2).

- Полная масса груза к доставке за 30 суток: 4,5 кг×(1+2)=13.5 кг.
- Финансовые затраты на логистику за один цикл (CostA): CostA=13.5 кг×1200000=$16 200 000

Таким образом, обеспечение одного космонавта 150 граммами свежей зелени в день в течение месяца путем прямой доставки с Земли обходится бюджету миссии в 16.2 млн долларов ежемесячно.

#### 3. Вариант Б: Модель локальной генерации (Аэропонная установка closed-loop)

Развертывание аэропонной установки пристенно-углового типа на 30 посадочных мест сопряжено со стартовыми затратами массы оборудования (капитальные затраты, САРЕХ) и текущими затратами на расходные материалы (операционные затраты, ОРЕХ).

Массовые затраты (капитальные — CAPEX):

- Сухая конструкционная масса оборудования (труба-колонна, датчики, автоматика, LED-штанги, отражатели, бак): 12.0 кг.
- Масса первоначальной технологической воды в контуре: 15.0 кг.
- Итого стартовая масса системы: 27.0 кг.
- Финансовый эквивалент доставки оборудования: 27.0 кг×1200000=$32 400 000 (разовая инвестиция, амортизируется за годы работы базы).

Расходные материалы за 1 цикл (операционные — OPEX): Для производства 4.5 кг целевой биомассы (кейл, мангольд, базилик) установка требует восполнения безвозвратных ресурсных потерь. Благодаря замкнутому контуру и системе конденсации влаги, безвозвратные потери воды составляют всего 1.5 литра на 1 кг готовой продукции. Расход сухих минеральных солей (удобрений) зафиксирован ТЗ на уровне 20 грамм на 1 кг биомассы.

DOCX

- Расход технологической воды: 4.5 кг×1.5 л/кг=6.75 кг.
- Расход сухих удобрений: 4.5 кг×0.02 кг/кг=0.09 кг.
- Логистическая масса семенного фонда (3 семени в лунку × 30 лунок): ≈0.005 кг.
- Итого ОРЕХ-масса снабжения на 30 суток: 6.75+0.09+0.005=6.845 кг.
- Финансовые затраты на эксплуатацию за один цикл (CostB): CostB=6.845 кг×1200000=$8 214 000

#### 1.2. Сравнительный анализ и точка окупаемости системы

Сопоставление затрат показывает, что операционные расходы на содержание замкнутой аэропонной системы (CostB=$8.214 млн) сопоставимы с затратами на прямую доставку еды (CostA=$16.200 млн) уже в рамках самого первого вегетационного цикла (30 суток).

Срок окупаемости стартовой массы оборудования (ROI) рассчитывается как:

ROI = CAPEX/Экономия в месяц = 32.4/(16.2-8.214) = 4,05 месяца

Начиная со пятого месяца эксплуатации, за счет полной компенсации стартовой массы (CAPEX) и зацикливания регенерации воды, система начинает генерировать чистую экономию:

- Каждый последующий месяц прямая доставка 4,5 кг зелени продолжала бы требовать $16.2 млн.
- Аэропонная установка требует подвоза с Земли только сухих солей (90 г) и семян (5 г), воды (6,75 кг).
- Экономит бюджету миссии почти 8 млн долларов ежемесячно на одного члена экипажа.
