nika-cell/moon-aeroponics/Расчеты/график зависимости коэфф. от концн..png

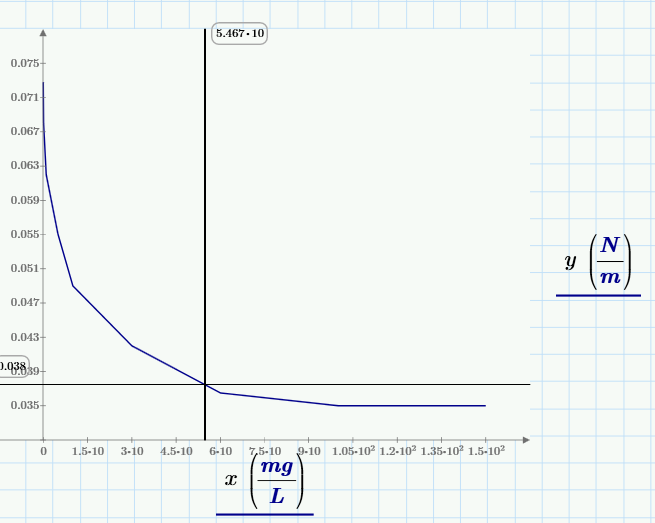
Расчеты/график зависимости коэфф. от концн..png
