nika-cell/moon-aeroponics/Расчеты/массив данных для постройки графика.png

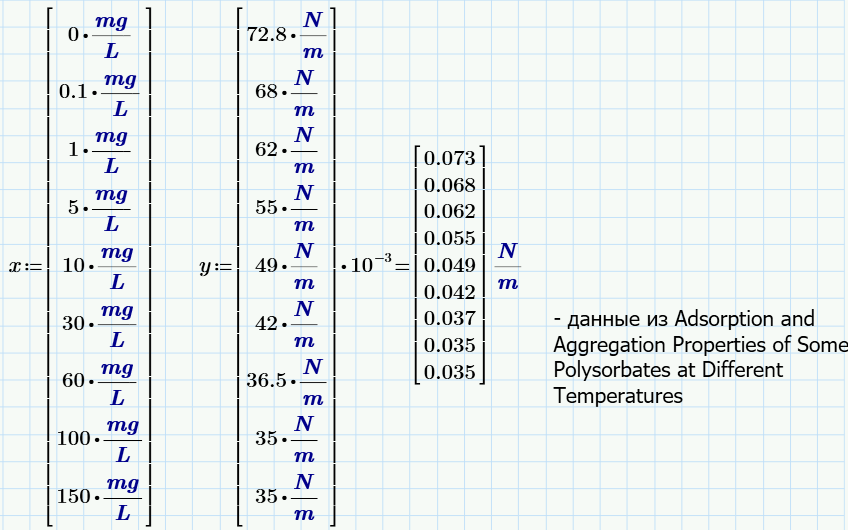
Расчеты/массив данных для постройки графика.png
