nika-cell/moon-aeroponics/Расчеты/Минимальная необходимая скорость для сдува капли.png

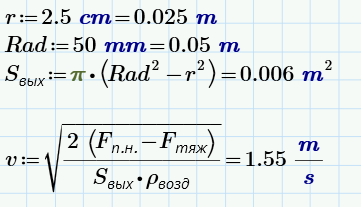
Расчеты/Минимальная необходимая скорость для сдува капли.png
