nika-cell/moon-aeroponics/Расчеты/Обоснование необходимости в вентиляторах.png

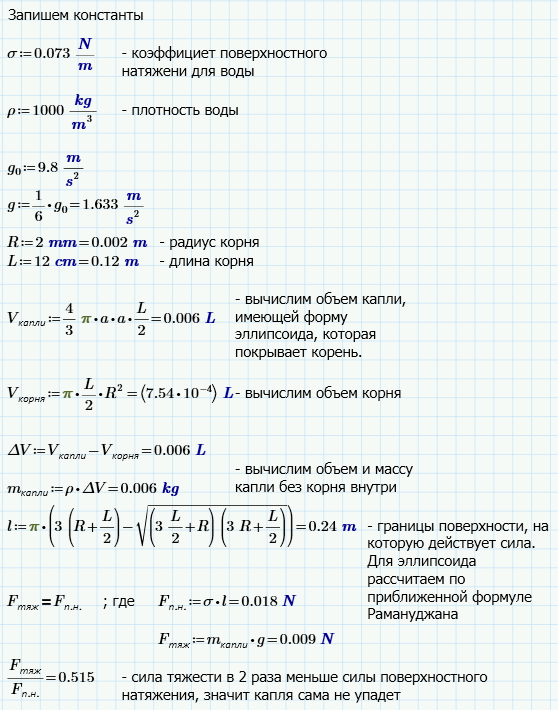
Расчеты/Обоснование необходимости в вентиляторах.png
