nika-cell/moon-aeroponics/Расчеты/Расчет давления потока воздуха от вентиляторов.png

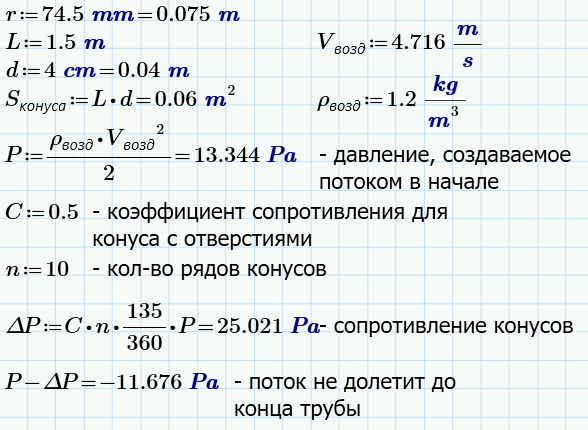
Расчеты/Расчет давления потока воздуха от вентиляторов.png
