nika-cell/moon-aeroponics/Расчеты/Расчет скорости выдаваемой нашим вентилятором.png

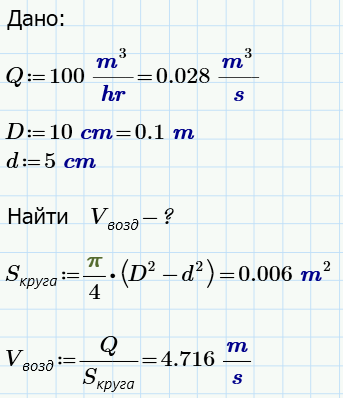
Расчеты/Расчет скорости выдаваемой нашим вентилятором.png
