nika-cell/moon-aeroponics/Расчеты/Расчет угла наколона вентилятора и скорости потока в конце цилиндра с учетом сопротивления.png

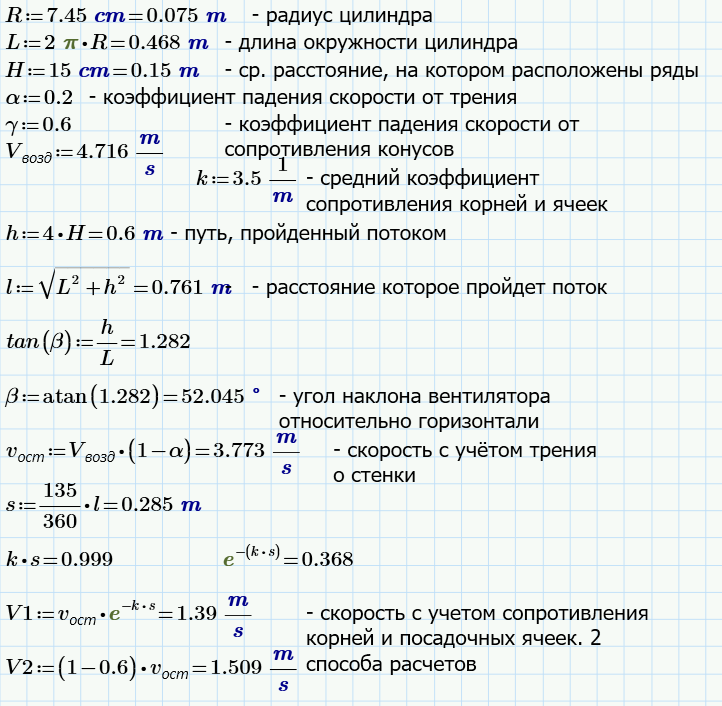
Расчеты/Расчет угла наколона вентилятора и скорости потока в конце цилиндра с учетом сопротивления.png
