nika-cell/moon-aeroponics/Электроника/Макетная плата элк_схемы.png

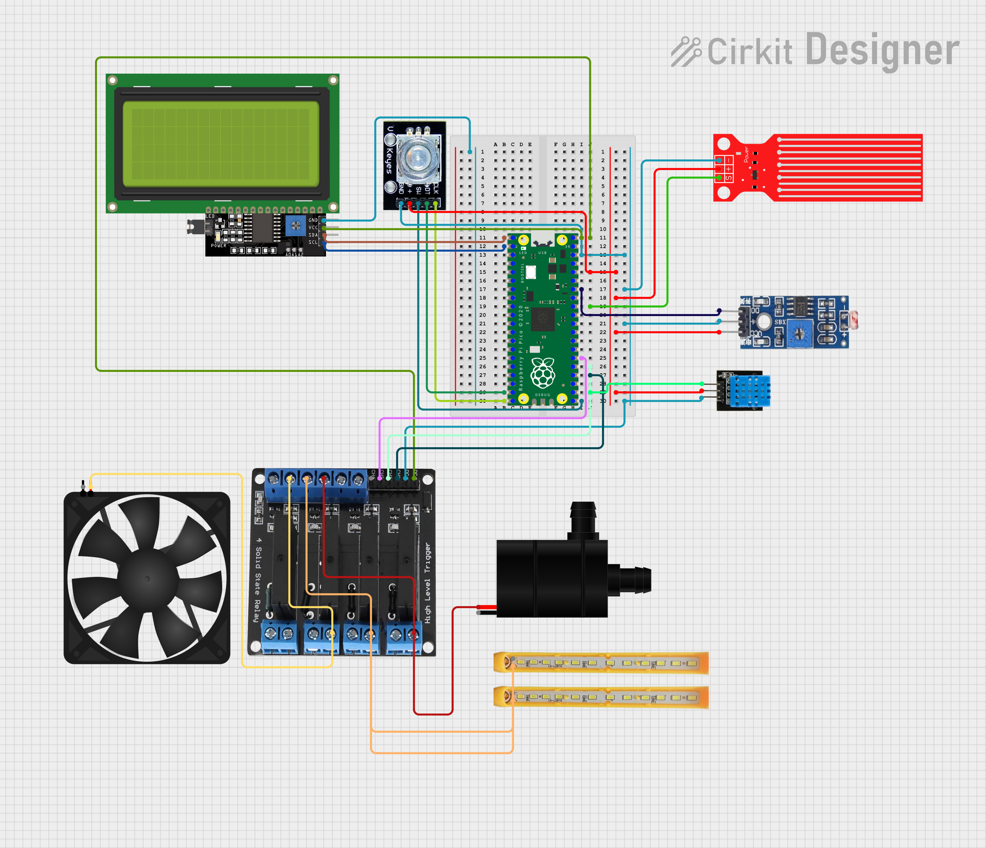
Электроника/Макетная плата элк_схемы.png
