nika-cell/moon-aeroponics/3d модель/2 шт соед ручка 2 верх 1.stl

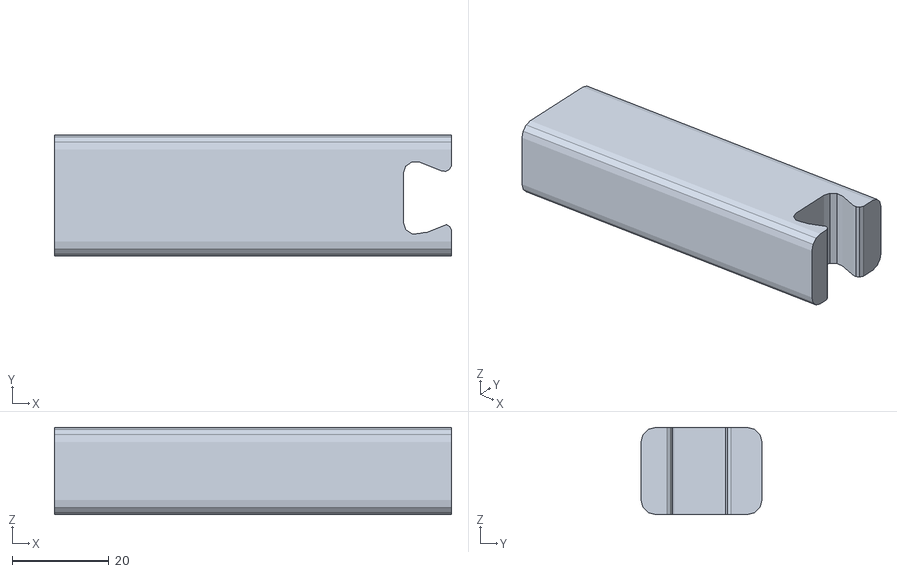
[picture p13: CAD file, 2026-07-17]
3d модель/2 шт соед ручка 2 верх 1.stl
82.0 x 25.0 x 18.0
