nika-cell/moon-aeroponics/3d модель/1 шт соединения 1 вверх смотрят тип снизу 1.stl

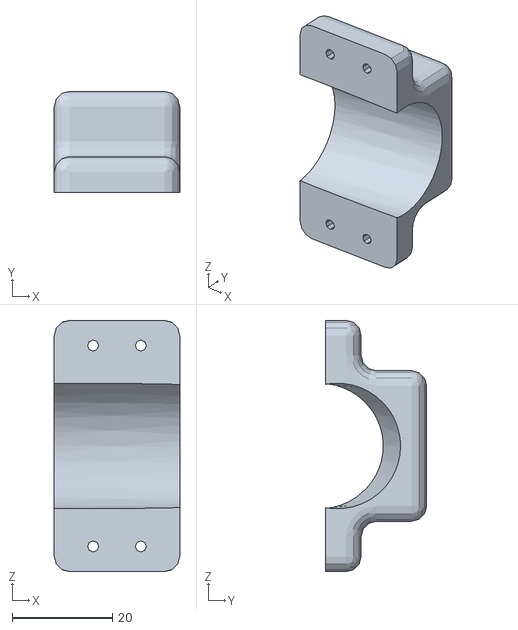
[picture p14: CAD file, 2026-07-17]
3d модель/1 шт соединения 1 вверх смотрят тип снизу 1.stl
25.0 x 20.1 x 50.0
