nika-cell/moon-aeroponics/3d модель/2 шт тип 1 снизу.stl

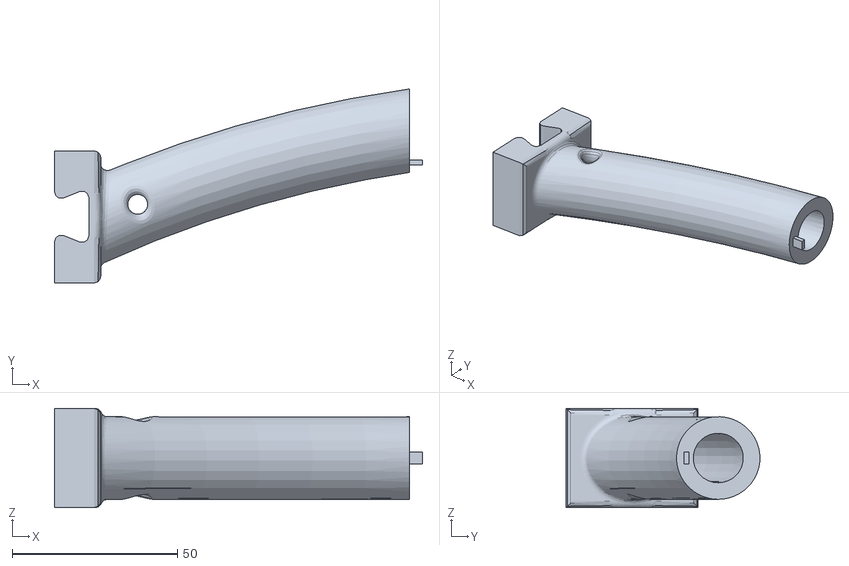
[picture p15: CAD file, 2026-07-17]
3d модель/2 шт тип 1 снизу.stl
111.3 x 58.7 x 30.0
