nika-cell/moon-aeroponics/3d модель/1 шт нижний фито крепление 15.stl

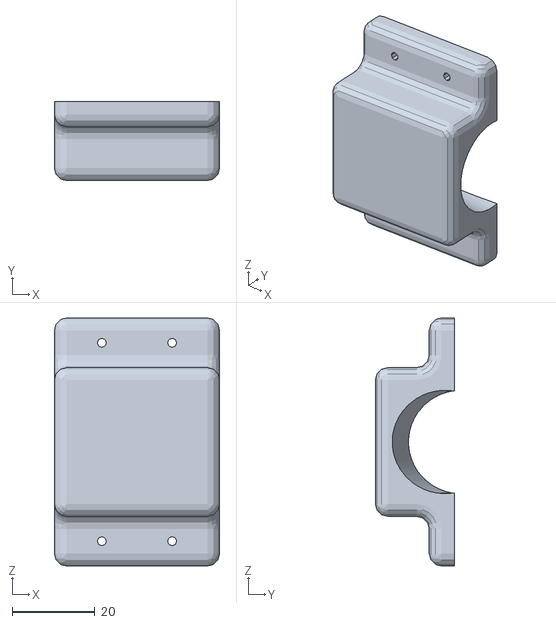
[picture p16: CAD file, 2026-07-17]
3d модель/1 шт нижний фито крепление 15.stl
40.0 x 19.1 x 60.0
