nika-cell/moon-aeroponics/3d модель/бак.stl

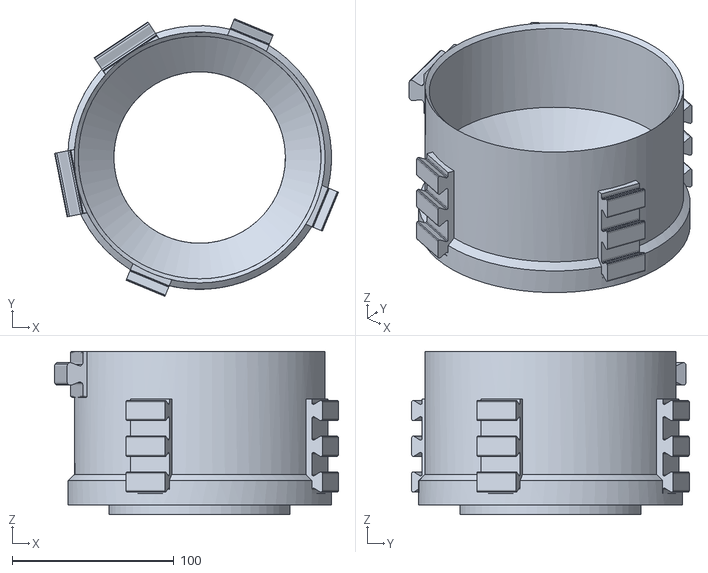
[picture p17: CAD file, 2026-07-17]
3d модель/бак.stl
175.5 x 171.6 x 101.0
