nika-cell/moon-aeroponics/3d модель/4 шт соед верхний фито просто крепление.stl

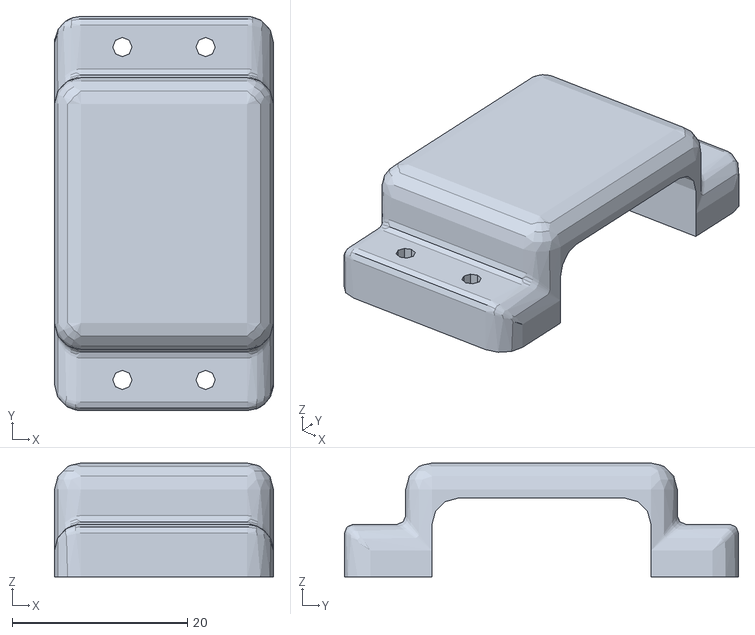
[picture p18: CAD file, 2026-07-17]
3d модель/4 шт соед верхний фито просто крепление.stl
25.0 x 45.0 x 13.0
