nika-cell/moon-aeroponics/3d модель/12 шт колбочка.stl

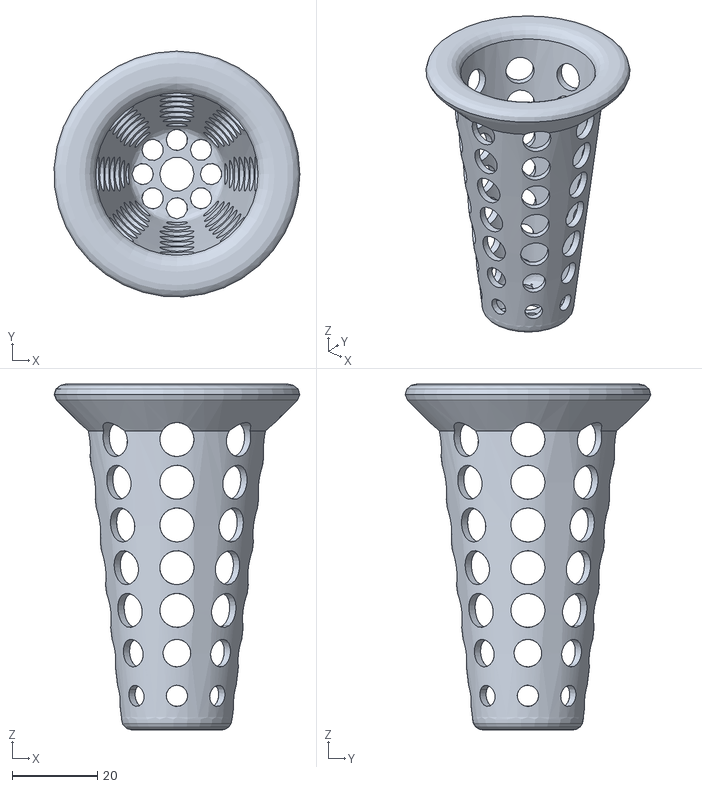
[picture p20: CAD file, 2026-07-17]
3d модель/12 шт колбочка.stl
57.5 x 57.5 x 81.0
