nika-cell/moon-aeroponics/3d модель/2 шт тип 2 снизу.stl

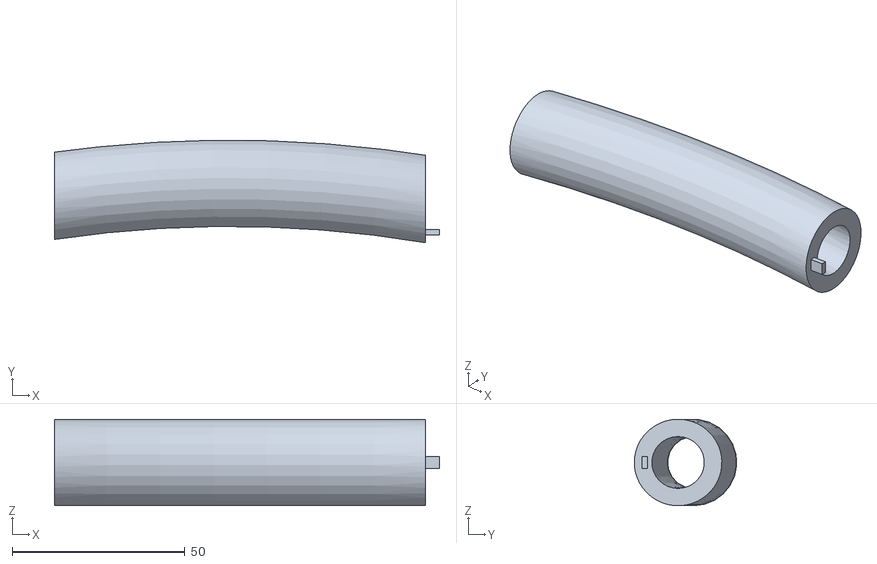
[picture p21: CAD file, 2026-07-17]
3d модель/2 шт тип 2 снизу.stl
111.3 x 29.6 x 25.0
