nika-cell/moon-aeroponics/3d модель/2 шт соед ручка 2 верх 2.stl

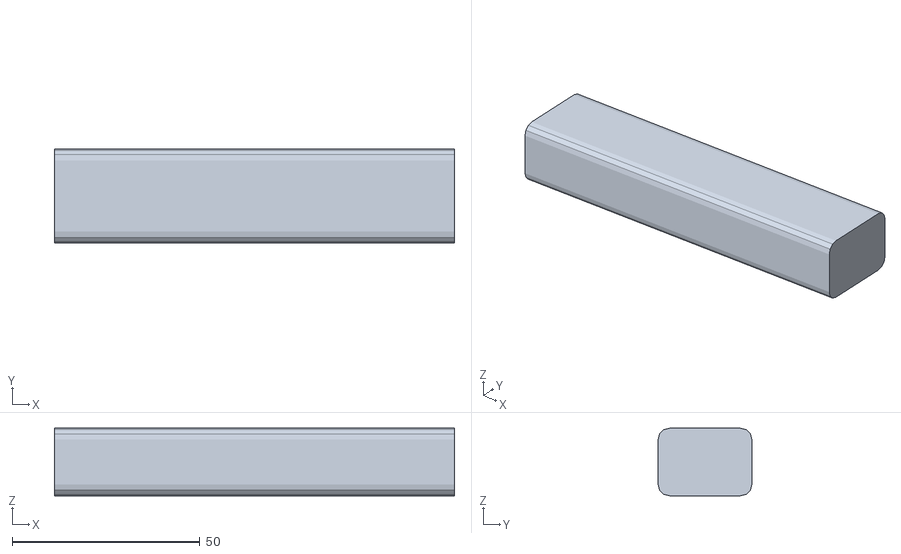
[picture p22: CAD file, 2026-07-17]
3d модель/2 шт соед ручка 2 верх 2.stl
106.6 x 25.0 x 18.0
