nika-cell/moon-aeroponics/3d модель/ребро жесткости бака.stl

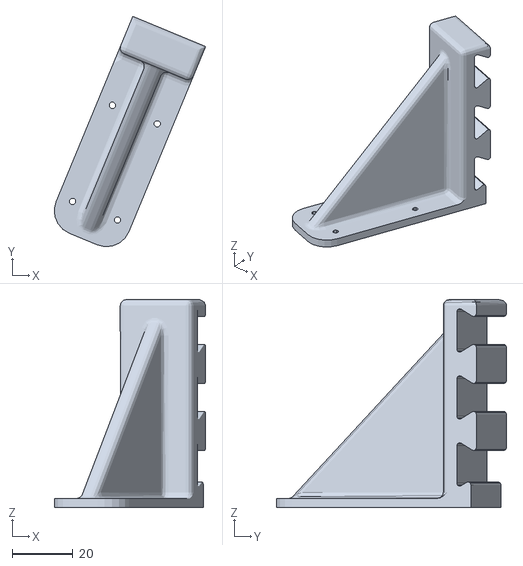
[picture p23: CAD file, 2026-07-17]
3d модель/ребро жесткости бака.stl
49.9 x 75.9 x 68.6
