nika-cell/moon-aeroponics/3d модель/2 шт тип 3 снизу.stl

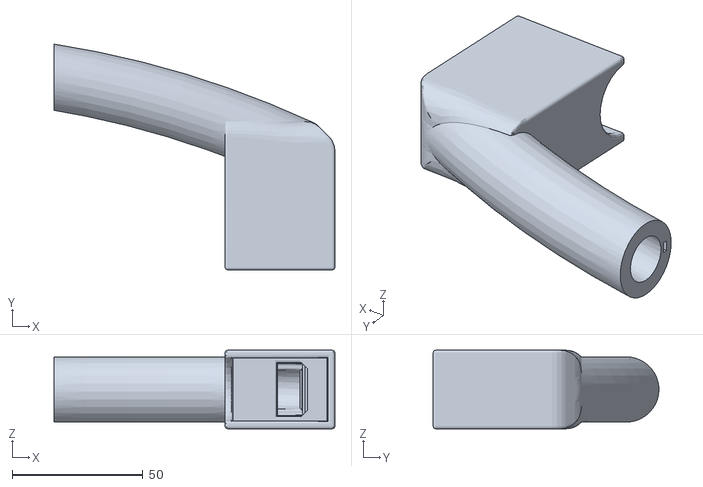
[picture p24: CAD file, 2026-07-17]
3d модель/2 шт тип 3 снизу.stl
107.3 x 86.3 x 30.0
