nika-cell/moon-aeroponics/3d модель/3 шт работаем без лопастей.stl

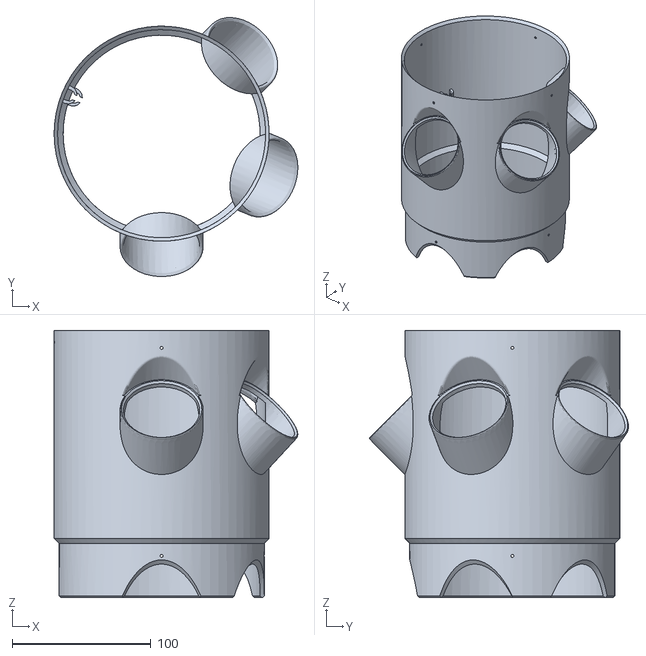
[picture p25: CAD file, 2026-07-17]
3d модель/3 шт работаем без лопастей.stl
175.7 x 186.6 x 192.5
