nika-cell/moon-aeroponics/3d модель/1 шт крышка.stl

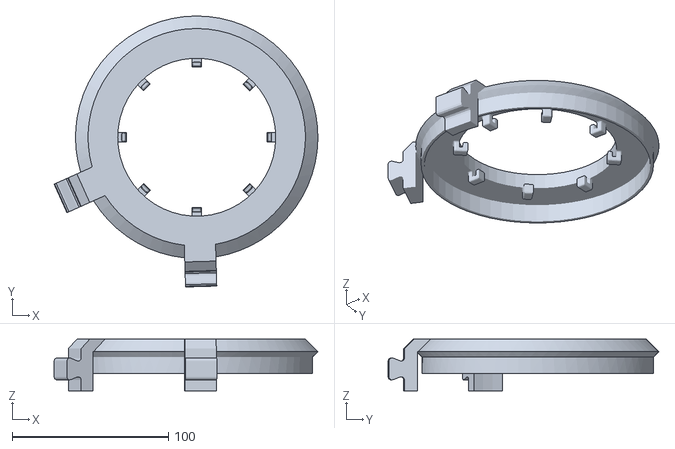
[picture p27: CAD file, 2026-07-17]
3d модель/1 шт крышка.stl
168.7 x 173.3 x 33.0
