nika-cell/moon-aeroponics/3d модель/2 шт соед креп 2 верх фито.stl

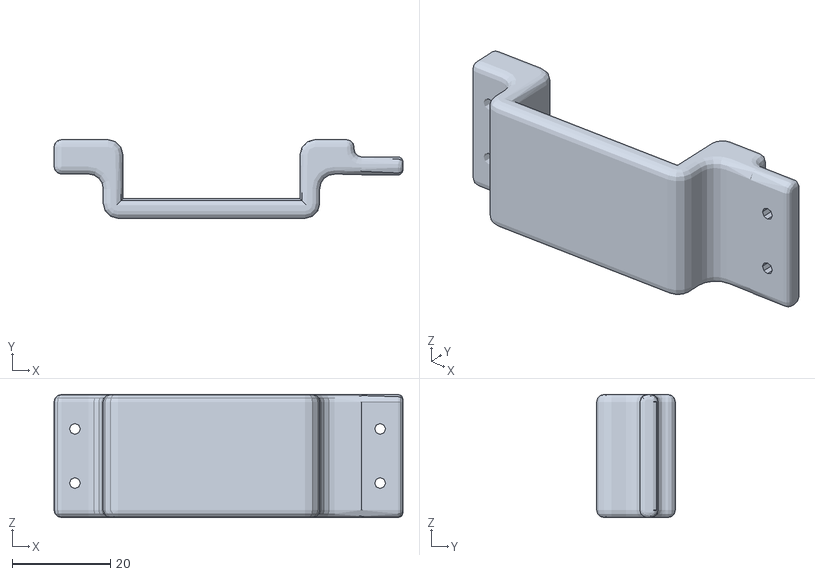
[picture p28: CAD file, 2026-07-17]
3d модель/2 шт соед креп 2 верх фито.stl
70.9 x 16.0 x 25.0
