nika-cell/moon-aeroponics/(list of files, cad)

Other CAD files:
3d модель/1 шт соединения 1 вверх смотрят тип снизу 2.stl
3d модель/1 шт соединения 1 вниз смотрят тип снизу 2.stl
3d модель/1 шт соединения 1 вниз смотрят тип снизу 1.stl
