nika-cell/moon-aeroponics/(commit log)

2026-07-03 Создание репозитория
2026-07-03 выращивание
2026-07-05 Презентация для защиты 1
2026-07-10 Измение структуры и актуализация доков
2026-07-10 Добавление 3д модели
2026-07-10 Преза гидра и электичество
2026-07-10 Прошивка для пико
2026-07-10 Сделала слайд про гипоксию
2026-07-10 Презентация добавели слайд по выбору культур и экономике
2026-07-10 Рассчет гипоксии
2026-07-10 Презентация электроника Ника
2026-07-11 Убран спец символ в отчете
2026-07-11 макетка
2026-07-11 Исправлена цель и добавлены оставшиеся задачи
2026-07-11 добавление расчетов
2026-07-11 добавила финальные расчеты
2026-07-14 добавила расчеты с маткада
2026-07-15 Проведен расчёт расстояния от ламп до растений
2026-07-16 ласт версия презентации
2026-07-17 добавила таблицу с энергопотреблением
2026-07-17 отчет по тепло и влаго выделению
2026-07-17 добавили все модельки
    [1 шт крышка.stl, 1 шт нижний фито крепление 15 еще один.stl, 1 шт нижний фито крепление 15.stl, 1 шт соединения 1 вверх смотрят тип снизу 1.stl, 1 шт соединения 1 вверх смотрят тип снизу 2.stl, 1 шт соединения 1 вниз смотрят тип снизу 1.stl, 1 шт соединения 1 вниз смотрят тип снизу 2.stl, 12 шт колбочка.stl]
2026-07-18 Презентация с расчетом циклограммы
2026-07-18 график ремейк
2026-07-18 преза эл
2026-07-18 сделала слайды про 2 варианта решения проблемы с вентиляторами и павом
2026-07-19 расчеты
2026-07-19 слайды для юрия
2026-07-21 Update прошивка пико.py
2026-07-21 объеденила слайд 14
2026-07-22 Отредактированы все расчёты и переведены в ПДФ
